troubadour-tardigrade/TnTech-SAE-Aero-Design/README.md

# TnTech-SAE-Aero-Design
Personal work associated with the SAE Aero Design team at Tennessee Tech University competing in Regular Class.
