troubadour-tardigrade/TnTech-SAE-Aero-Design/Prop_Power_vs_Velocity.png

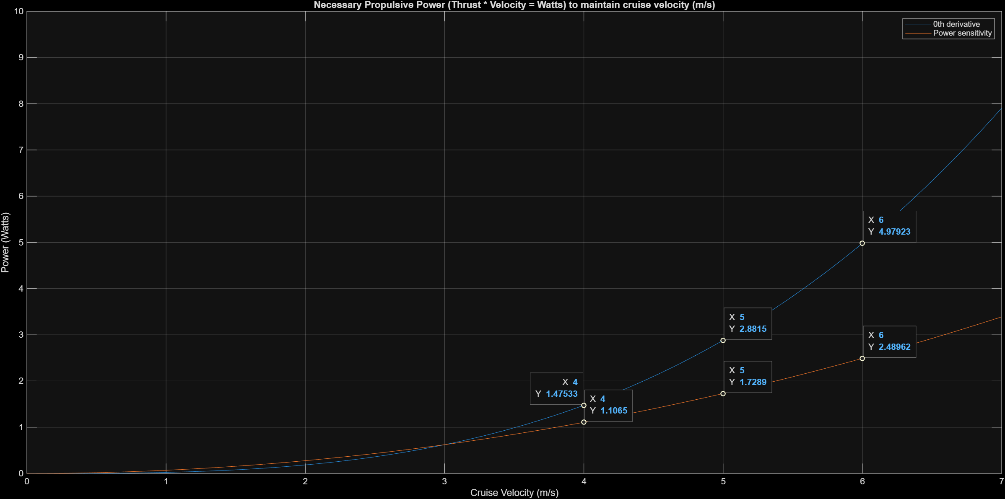
Prop_Power_vs_Velocity.png
