troubadour-tardigrade/TnTech-SAE-Aero-Design/Testing and DAQ/Propulsion Test Stand/GE4-PROPULSION-A-001 (TORQUE THRUST TEST STAND).SLDASM

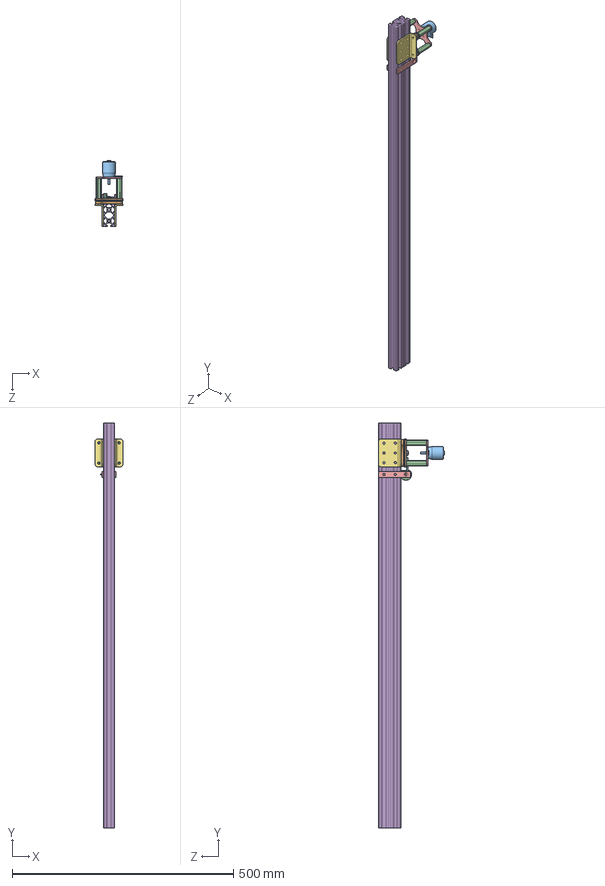
[picture p38: CAD file, 2026-10-03]
Testing and DAQ/Propulsion Test Stand/GE4-PROPULSION-A-001 (TORQUE THRUST TEST STAND).SLDASM
63.5 x 914.4 x 149.6 mm
motorAdapter_19x19
94868A766_Female Threaded Hex Standoff x 4
Skywalker_2320_simplified
GE4-ELECTRICAL-P-001-(bearing plate) x 3
GE4-PROPULSION-P-007 (BEARING)
GE4-PROPULSION-P-004 (TORQUE ARM)
motorMount8020 x 2
47065T419_T-Slotted Framing
GE4-PROPULSION-P-005 (LOAD CELL T SLOT MOUNT BAR) x 2
GE4-PROPULSION-P-003 (SINGLE LOAD CELL PIN MOUNT)
GE4-PROPULSION-P-006 (BEARING PLATE SPACER)
90591A151_Zinc-Plated Steel Hex Nut_M6_Stand_In
92000A424_Passivated 18-8 Stainless Steel Pan Head Phillips Screws_Stand_In
