troubadour-tardigrade/TnTech-SAE-Aero-Design/Testing and DAQ/Propulsion Test Stand/GE4-PROPULSION-P-004 (TORQUE ARM).SLDPRT

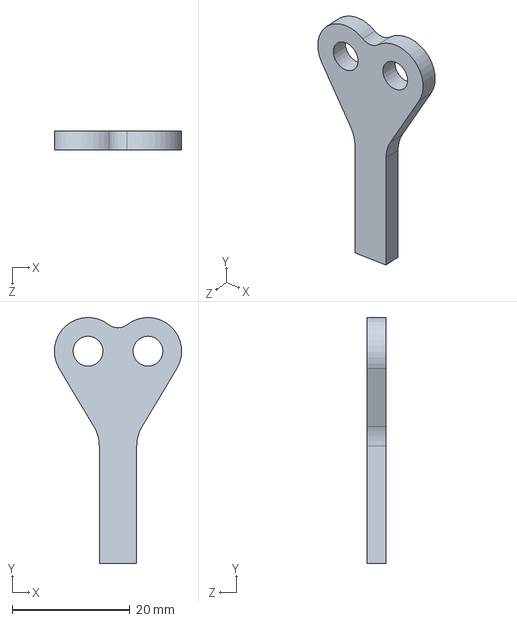
[picture p39: CAD file, 2026-10-03]
Testing and DAQ/Propulsion Test Stand/GE4-PROPULSION-P-004 (TORQUE ARM).SLDPRT
21.6 x 41.7 x 3.17 mm
