troubadour-tardigrade/TnTech-SAE-Aero-Design/Testing and DAQ/Propulsion Test Stand/motorAdapter_19x19.SLDPRT

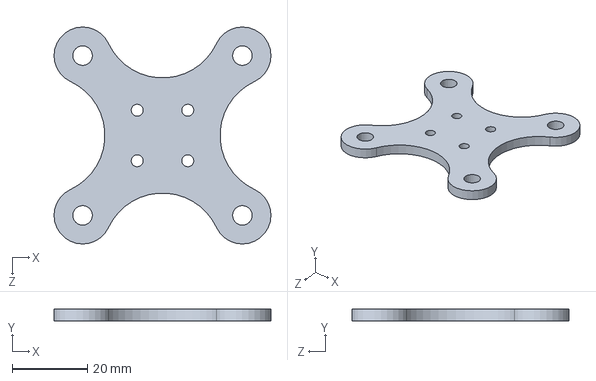
[picture p40: CAD file, 2026-10-03]
Testing and DAQ/Propulsion Test Stand/motorAdapter_19x19.SLDPRT
57.6 x 3.17 x 57.6 mm
