troubadour-tardigrade/TnTech-SAE-Aero-Design/Testing and DAQ/Propulsion Test Stand/GE4-PROPULSION-P-003 (SINGLE LOAD CELL PIN MOUNT).SLDPRT

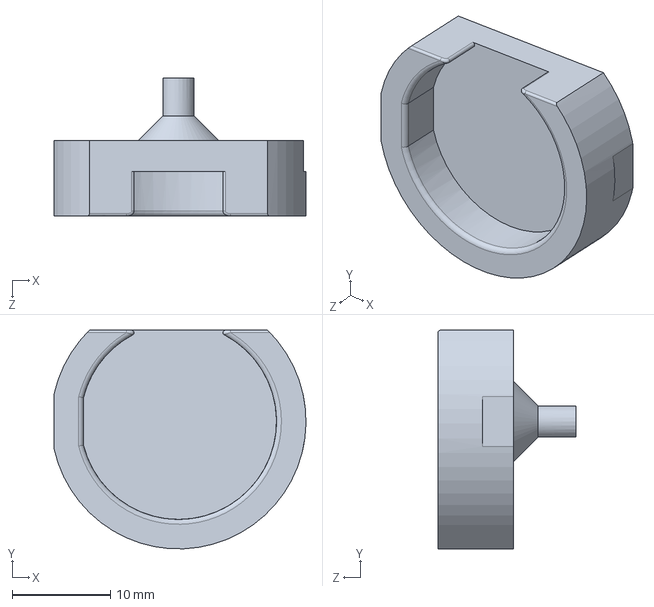
[picture p41: CAD file, 2026-10-03]
Testing and DAQ/Propulsion Test Stand/GE4-PROPULSION-P-003 (SINGLE LOAD CELL PIN MOUNT).SLDPRT
25.6 x 22.2 x 14.0 mm
