troubadour-tardigrade/TnTech-SAE-Aero-Design/Testing and DAQ/Propulsion Test Stand/GE4-ELECTRICAL-P-001-(bearing plate).SLDPRT

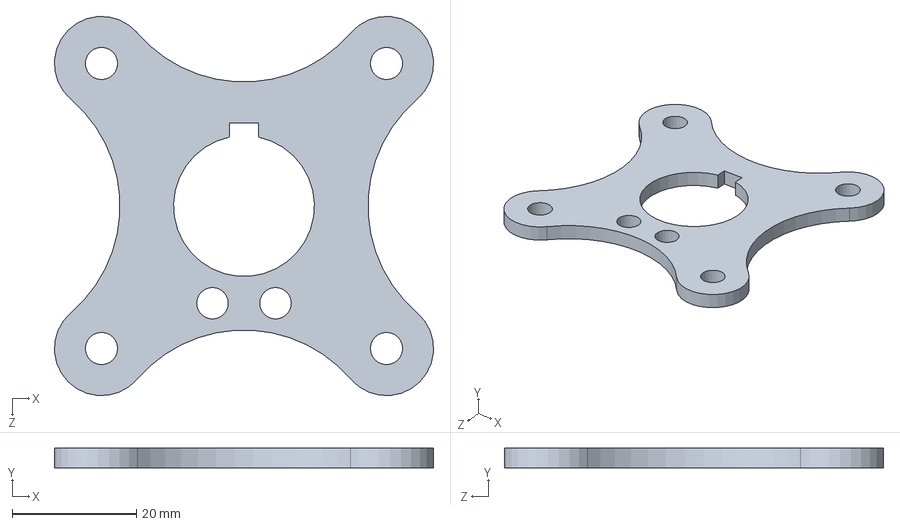
[picture p42: CAD file, 2026-10-03]
Testing and DAQ/Propulsion Test Stand/GE4-ELECTRICAL-P-001-(bearing plate).SLDPRT
61.1 x 3.17 x 61.1 mm
