troubadour-tardigrade/TnTech-SAE-Aero-Design/Testing and DAQ/Propulsion Test Stand/GE4-PROPULSION-P-005 (LOAD CELL T SLOT MOUNT BAR).SLDPRT

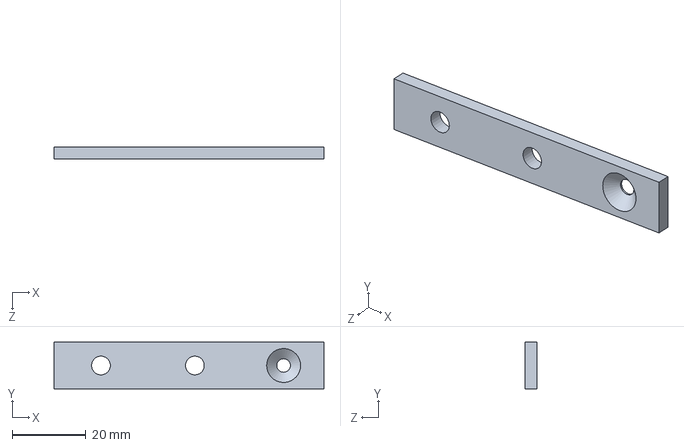
[picture p43: CAD file, 2026-10-03]
Testing and DAQ/Propulsion Test Stand/GE4-PROPULSION-P-005 (LOAD CELL T SLOT MOUNT BAR).SLDPRT
73.0 x 12.7 x 3.17 mm
