troubadour-tardigrade/TnTech-SAE-Aero-Design/Testing and DAQ/Propulsion Test Stand/GE4-PROPULSION-P-006 (BEARING PLATE SPACER).SLDPRT

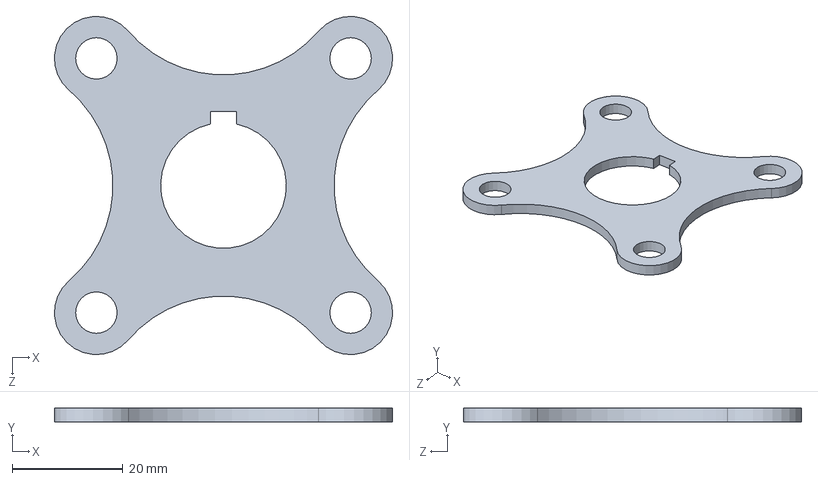
[picture p44: CAD file, 2026-10-03]
Testing and DAQ/Propulsion Test Stand/GE4-PROPULSION-P-006 (BEARING PLATE SPACER).SLDPRT
61.1 x 2.54 x 61.1 mm
