troubadour-tardigrade/TnTech-SAE-Aero-Design/Testing and DAQ/Propulsion Test Stand/motorMount8020.SLDPRT

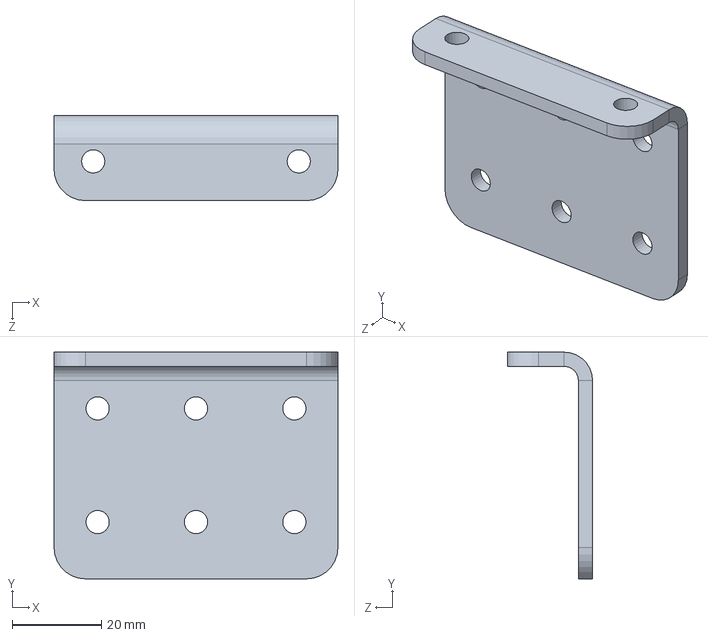
[picture p45: CAD file, 2026-10-03]
Testing and DAQ/Propulsion Test Stand/motorMount8020.SLDPRT
63.5 x 50.7 x 19.1 mm
