troubadour-tardigrade/TnTech-SAE-Aero-Design/Testing and DAQ/Propulsion Test Stand/GE4-PROPULSION-P-007 (BEARING).SLDPRT

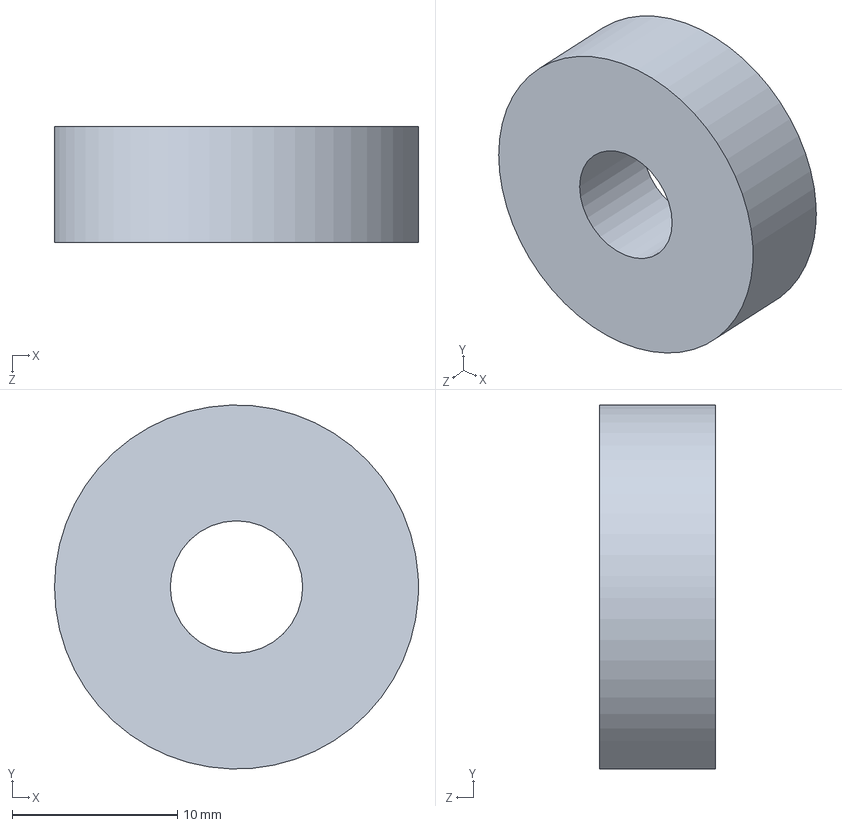
[picture p46: CAD file, 2026-10-03]
Testing and DAQ/Propulsion Test Stand/GE4-PROPULSION-P-007 (BEARING).SLDPRT
22.0 x 22.0 x 7.00 mm
