troubadour-tardigrade/TnTech-SAE-Aero-Design/Testing and DAQ/Propulsion Test Stand/Skywalker_2320_simplified.SLDPRT

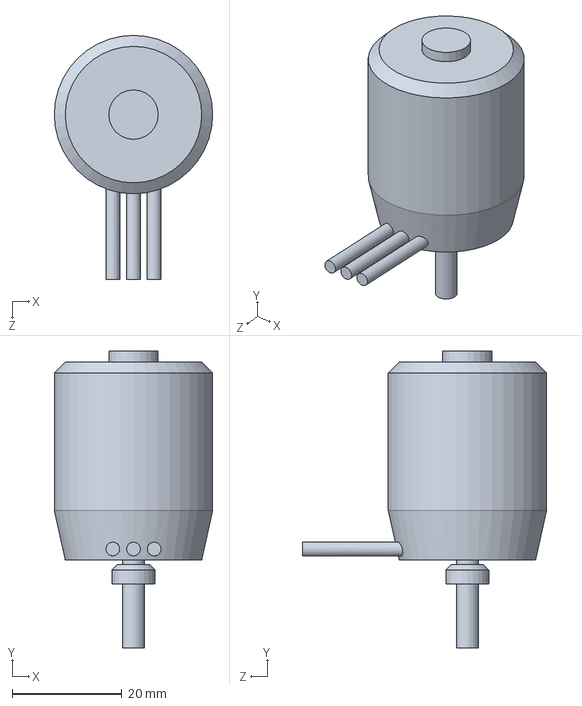
[picture p47: CAD file, 2026-10-03]
Testing and DAQ/Propulsion Test Stand/Skywalker_2320_simplified.SLDPRT
28.8 x 54.0 x 44.4 mm
