troubadour-tardigrade/TnTech-SAE-Aero-Design/Testing and DAQ/Propulsion Test Stand/94868A766_Female Threaded Hex Standoff.SLDPRT

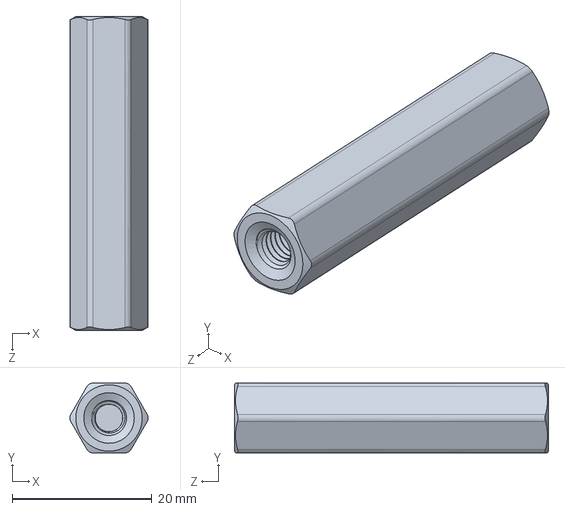
[picture p48: CAD file, 2026-10-03]
Testing and DAQ/Propulsion Test Stand/94868A766_Female Threaded Hex Standoff.SLDPRT
11.2 x 10.0 x 45.0 mm
