troubadour-tardigrade/TnTech-SAE-Aero-Design/Testing and DAQ/Propulsion Test Stand/47065T419_T-Slotted Framing.SLDPRT

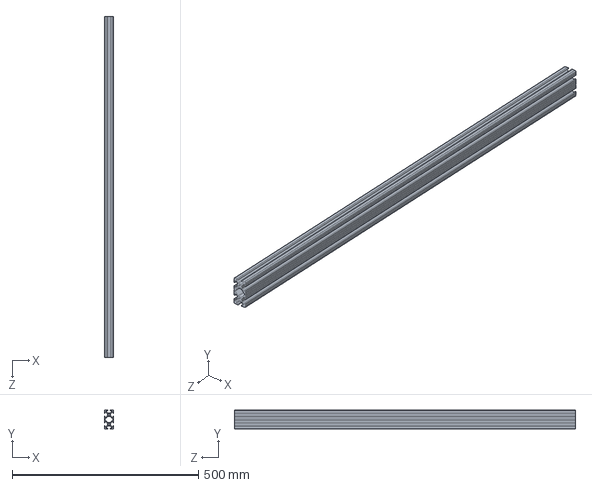
[picture p49: CAD file, 2026-10-03]
Testing and DAQ/Propulsion Test Stand/47065T419_T-Slotted Framing.SLDPRT
25.4 x 50.8 x 914.4 mm
