troubadour-tardigrade/TnTech-SAE-Aero-Design/Testing and DAQ/Propulsion Test Stand/90591A151_Zinc-Plated Steel Hex Nut_M6_Stand_In.SLDPRT

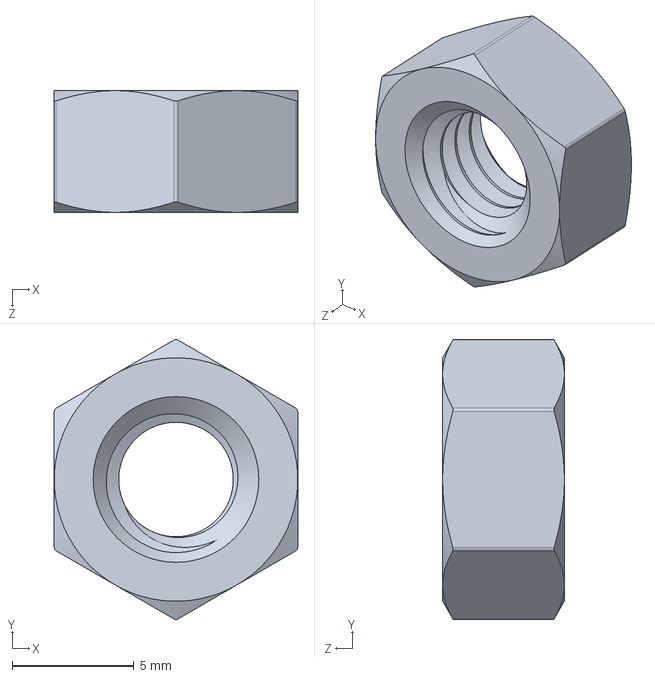
[picture p50: CAD file, 2026-10-03]
Testing and DAQ/Propulsion Test Stand/90591A151_Zinc-Plated Steel Hex Nut_M6_Stand_In.SLDPRT
10.0 x 11.5 x 5.00 mm
