troubadour-tardigrade/TnTech-SAE-Aero-Design/Testing and DAQ/Propulsion Test Stand/92000A424_Passivated 18-8 Stainless Steel Pan Head Phillips Screws_Stand_In.SLDPRT

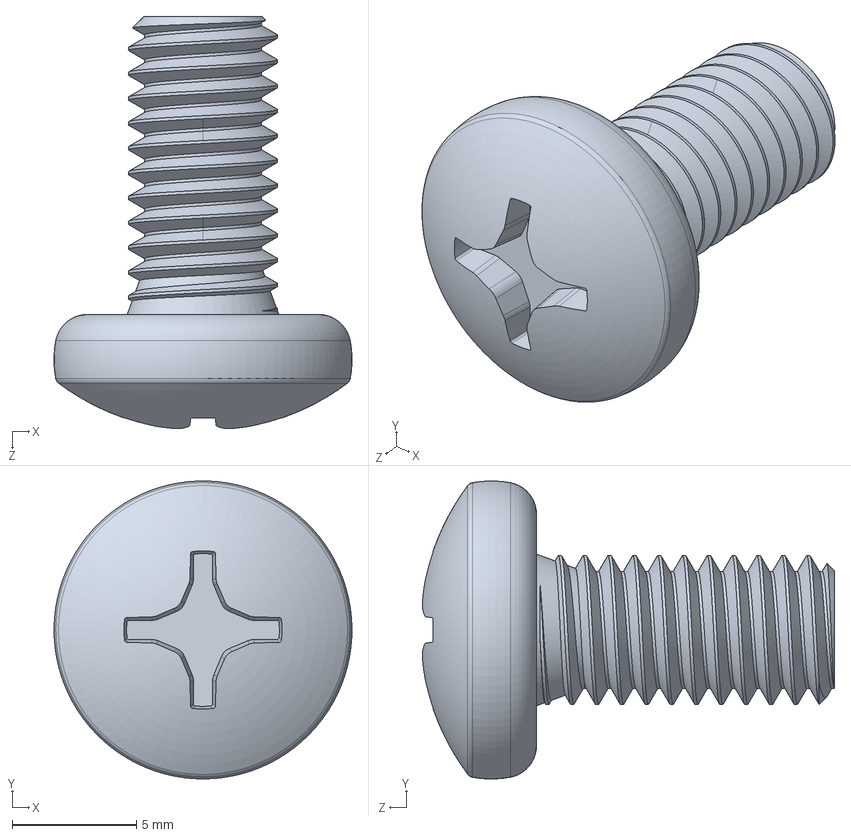
[picture p51: CAD file, 2026-10-03]
Testing and DAQ/Propulsion Test Stand/92000A424_Passivated 18-8 Stainless Steel Pan Head Phillips Screws_Stand_In.SLDPRT
12.0 x 12.0 x 16.6 mm
