troubadour-tardigrade/TnTech-SAE-Aero-Design/(list of files, cad)

Other CAD files:
Testing and DAQ/Propulsion Test Stand/GE4-PROPULSION-P-002 (2X3 90DEG 1X2 ANGLE BRACKET).SLDPRT
