troubadour-tardigrade/TnTech-SAE-Aero-Design/Testing and DAQ/README.md

Purpose of this folder is to catalog improvements made personally to testing and data acquisition (DAQ) in regards to the Tennessee Tech University Regular Class SAE Aero Design team.  

# Test Stands
## Propulsion Test Stand
Intended to measure propulsive, mechanical, and electrical power to calculate efficiency and converting electrical energy from a LiPo battery to propulsion energy generated by a single motor/propeller combination.
